Rehabilitation-Innovation/AnkleDynamometer/Hardware/AnkleDynamometer/AnkleDynamometer.kicad_pcb

## KiCad design Hardware/AnkleDynamometer/AnkleDynamometer.kicad_pcb (2026-08-28)

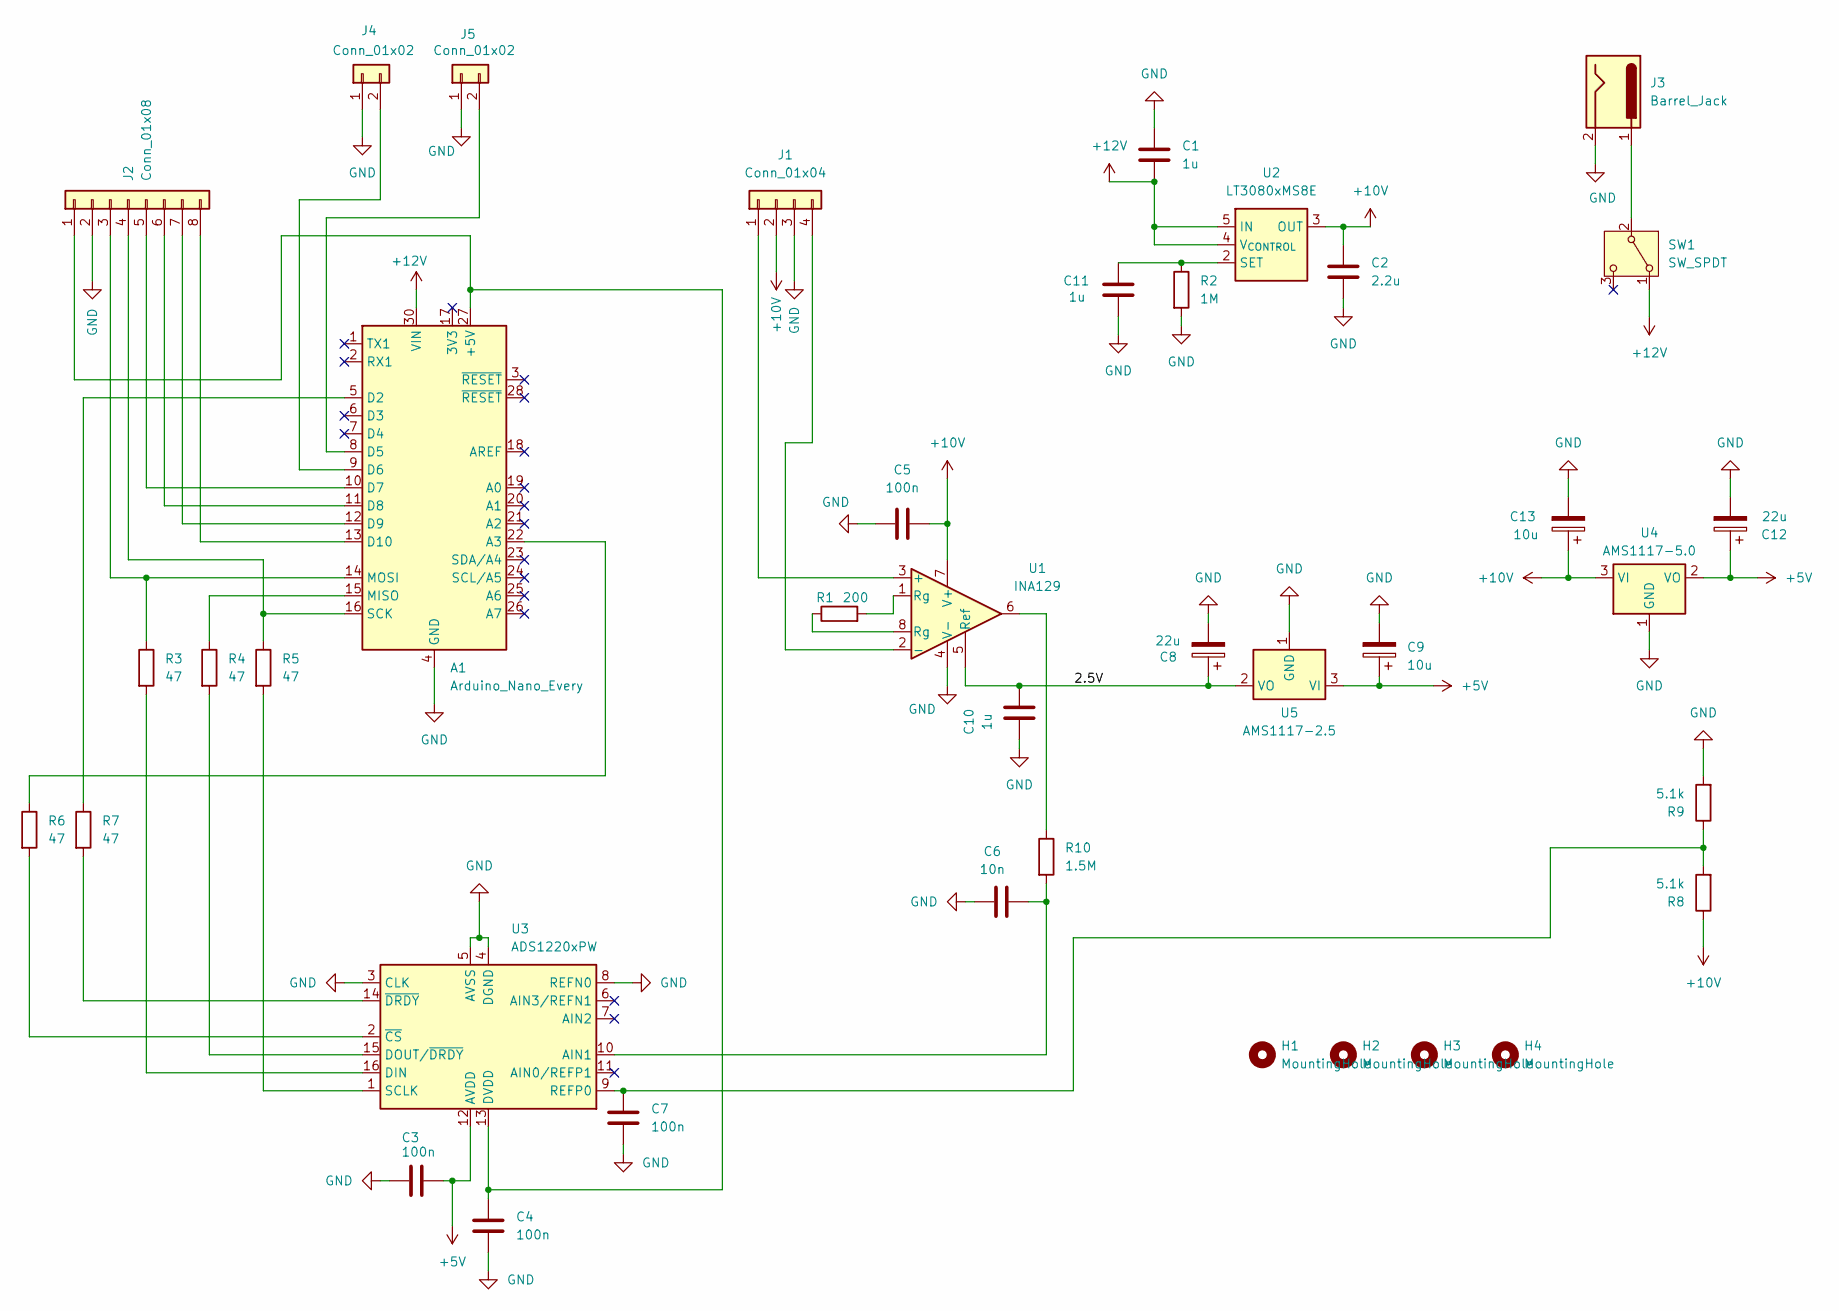
[picture p1: schematic AnkleDynamometer.kicad_sch]

Parts:
A1: Arduino_Nano_Every; Arduino_Nano
C1, C10, C11: 1u; C_0805_2012Metric; LCSC C28323
C2: 2.2u; C_1206_3216Metric; LCSC C50254
C3, C4, C5, C7: 100n; C_0603_1608Metric; LCSC C14663
C6: 10n; C_0603_1608Metric; LCSC C85973
C8, C12: 22u; CP_EIA-3216-18_Kemet-A; LCSC C11366
C9, C13: 10u; CP_EIA-3216-18_Kemet-A; LCSC C7171
H1, H2, H3, H4: MountingHole; MountingHole_2.2mm_M2_Pad_Via
J1: Conn_01x04; JST_EH_B4B-EH-A_1x04_P2.50mm_Vertical
J2: Conn_01x08; JST_EH_B8B-EH-A_1x08_P2.50mm_Vertical
J3: Barrel_Jack; BarrelJack_Horizontal
J4, J5: Conn_01x02; JST_EH_B2B-EH-A_1x02_P2.50mm_Vertical
R1: 200; R_0603_1608Metric_Pad0.98x0.95mm_HandSolder; LCSC C8218
R2: 1M; R_0603_1608Metric_Pad0.98x0.95mm_HandSolder; LCSC C22935
R3, R4, R5, R6, R7: 47; R_0603_1608Metric_Pad0.98x0.95mm_HandSolder; LCSC C23182
R8, R9: 5.1k; R_0603_1608Metric_Pad0.98x0.95mm_HandSolder; LCSC C23186
R10: 1.5M; R_0603_1608Metric_Pad0.98x0.95mm_HandSolder; LCSC C137773
SW1: SW_SPDT; SW_SLW-121586-5A-D
U1: INA129; DIP-8_W7.62mm
U2: LT3080xMS8E; TO-263-5_TabPin3; LCSC C580029
U3: ADS1220xPW; TSSOP-16_4.4x5mm_P0.65mm; LCSC C48263
U4: AMS1117-5.0; SOT-223-3_TabPin2; LCSC C6187
U5: AMS1117-2.5; SOT-223-3_TabPin2; LCSC C12087

Connections:
+5V: C3.1, C9.1, C12.1, U3.12 (AVDD), U4.2 (VO), U5.3 (VI)
+10V: C2.1, C5.2, C13.1, J1.2, R8.1, U1.7 (V+), U2.3 (OUT), U4.3 (VI)
+12V: A1.30 (VIN), C1.2, SW1.1 (A), U2.4 (V_{CONTROL}), U2.5 (IN)
/2.5V: C8.1, C10.2, U1.5 (Ref), U5.2 (VO)
GND: A1.4 (GND), A1.29 (GND), C1.1, C2.2, C3.2, C4.1, C5.1, C6.1, C7.1, C8.2, C9.2, C10.1, C11.2, C12.2, C13.2, J1.3, J2.2, J3.2, J4.1, J5.1, R2.2, R9.2, U1.4 (V-), U3.3 (CLK), U3.4 (DGND), U3.5 (AVSS), U3.8 (REFN0), U4.1 (GND), U5.1 (GND)
unnamed: A1.27 (+5V), C4.2, J2.1, U3.13 (DVDD)
unnamed: A1.22 (A3), R6.1
unnamed: A1.5 (D2), R7.1
unnamed: A1.8 (D5), J5.2
unnamed: A1.9 (D6), J4.2
unnamed: A1.10 (D7), J2.5
unnamed: A1.11 (D8), J2.6
unnamed: A1.12 (D9), J2.7
unnamed: A1.13 (D10), J2.8
unnamed: A1.15 (MISO), R4.1
unnamed: A1.14 (MOSI), J2.3, R3.1
unnamed: A1.16 (SCK), J2.4, R5.1
unnamed: J1.1, U1.3 (+)
unnamed: J1.4, U1.2 (-)
unnamed: R1.1, U1.8 (Rg)
unnamed: R1.2, U1.1 (Rg)
unnamed: R10.1, U1.6
unnamed: J3.1, SW1.2 (B)
unnamed: C11.1, R2.1, U2.2 (SET)
unnamed: C6.2, R10.2, U3.10 (AIN1)
unnamed: R3.2, U3.16 (DIN)
unnamed: R4.2, U3.15 (DOUT/~DRDY)
unnamed: C7.2, R8.2, R9.1, U3.9 (REFP0)
unnamed: R5.2, U3.1 (SCLK)
unnamed: R6.2, U3.2 (~CS)
unnamed: R7.2, U3.14 (~DRDY)

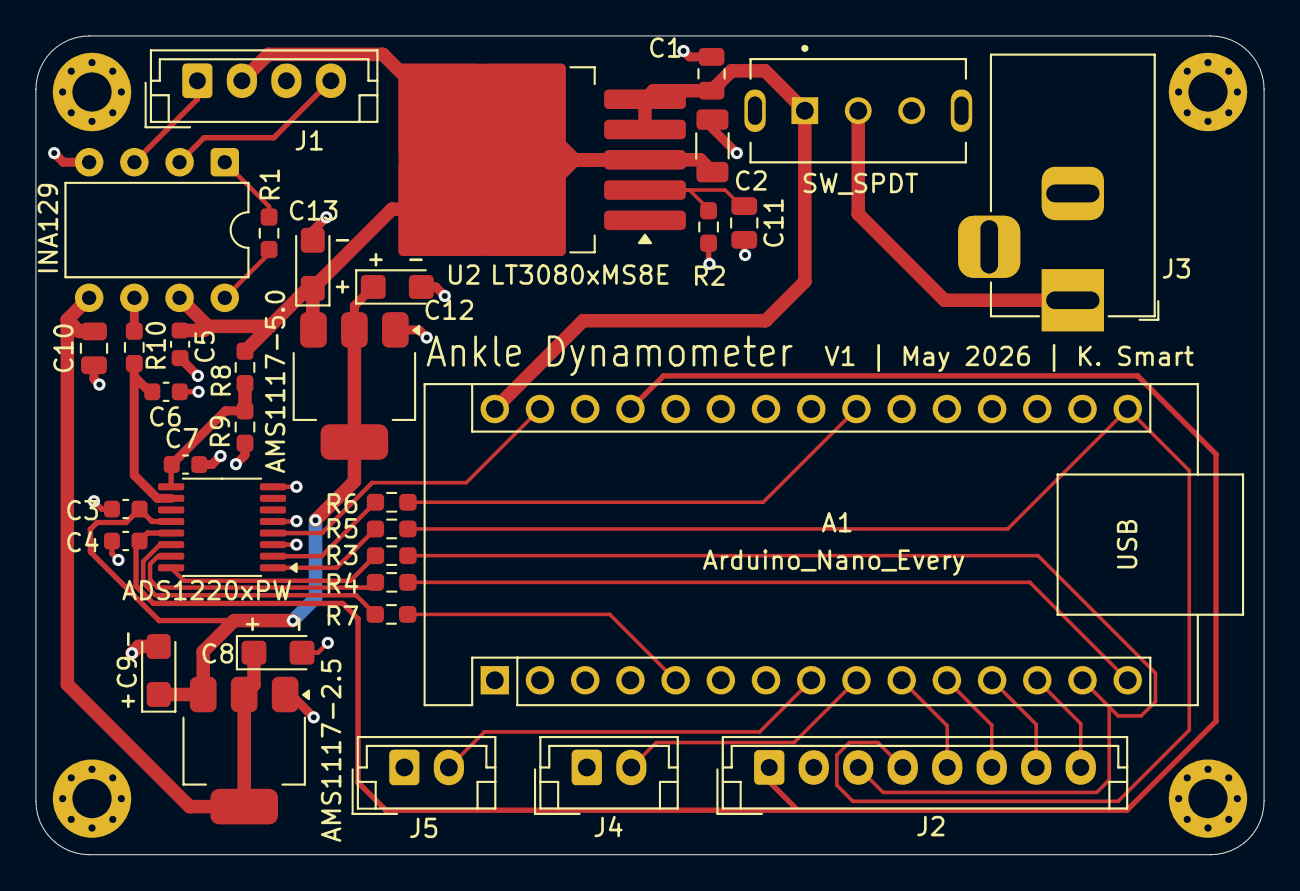
[picture p2: board AnkleDynamometer.kicad_pcb from above]

Board: 2 copper layers, 69.0 x 46.0 mm, 39 parts (0 on the bottom side), 31 nets.
