Rehabilitation-Innovation/AnkleDynamometer/txt_Calibration/RepeatabilityTest_27kg.txt

Config_Reg : 
1
4
50
0
 
4133721 8261748 12389632 16517263 20645080 24772977 28900767 33028641 37156283 41284112 45411801 49539408 53667024 57794662 61922440 66050385 70178090 74305637 78433180 82560916 Average: 4128045
0 -0.01 4127629
1 -0.01 4127751
2 -0.01 4127788
3 -0.00 4127847
4 -0.00 4127842
5 -0.01 4127814
6 -0.01 4127812
7 -0.01 4127808
8 -0.01 4127809
9 -0.01 4127797
10 -0.01 4127797
11 -0.01 4127776
12 -0.01 4127792
13 -0.01 4127777
14 -0.01 4127796
15 -0.01 4127834
16 -0.01 4127809
17 -0.01 4127819
18 -0.01 4127792
19 -0.01 4127800
20 -0.01 4127801
21 -0.01 4127770
22 -0.01 4127740
23 -0.01 4127740
24 -0.01 4127716
25 -0.01 4127701
26 -0.01 4127704
27 -0.01 4127685
28 -0.01 4127706
29 -0.01 4127672
30 -0.01 4127704
31 -0.01 4127735
32 -0.01 4127708
33 -0.01 4127743
34 -0.01 4127808
35 -0.00 4127901
36 -0.00 4127904
37 -0.00 4127953
38 -0.00 4127977
39 -0.00 4127979
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
