Rehabilitation-Innovation/AnkleDynamometer/LoadCellValidation.xlsx

Sheet: Calibration
0 | 4125106 | 0 | 4123962 | 0 | 4125617 | 0 | 4094992 |  |  | ADC Value
1 | 4125083 | 1 | 4123962 | 1 | 4125547 | 1 | 4095093 |  | Known masses | Increasing | Decreasing
2 | 4125034 | 2 | 4123964 | 2 | 4125484 | 2 | 4095054 |  | -18.3 | 3335661.19
3 | 4125053 | 3 | 4124032 | 3 | 4125568 | 3 | 4094994 |  | -9.2 | 3715514.19
4 | 4124961 | 4 | 4123943 | 4 | 4125394 | 4 | 4095040 |  | 0 | 4125184.048
5 | 4125116 | 5 | 4123946 | 5 | 4125419 | 5 | 4095012 |  | 9.0 | 4496124.3 | 4490965.714
6 | 4125079 | 6 | 4124057 | 6 | 4125525 | 6 | 4095035 |  | 18.1 | 4872486.762 | 4864073.095
7 | 4125149 | 7 | 4123990 | 7 | 4125475 | 7 | 4095351 |  | 27.3 | 5245785.143 | 5238596
8 | 4124993 | 8 | 4123951 | 8 | 4125473 | 8 | 4095022 |  | 34.9 | 5555335.952 | 5557937.571
9 | 4125070 | 9 | 4123972 | 9 | 4125502 | 9 | 4095149 |  | 44.3 | 5935980.095 | 5942394.286
10 | 4125058 | 10 | 4123923 | 10 | 4125647 | 10 | 4094994 |  | 55.1 | 6411038.333 | 6411038.333
11 | 4125046 | 11 | 4123949 | 11 | 4125472 | 11 | 4095105 |  | 62.8 | 6616478.429 | 6590787.238
12 | 4125028 | 12 | 4123956 | 12 | 4125496 | 12 | 4094978 |  | 70.4 | 6920726
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
