Rehabilitation-Innovation/AnkleDynamometer/AnklePositionValidation.xlsx

Sheet: Sheet1
95% range | plot distance | Max plantar | Max dorsi | Block [in] | Block [mm] |  |  | 0.375
1.5 | 10 | 30 | -10 | 0.5 | 12.7
L1 | h | L2 | L3 | BC | beta [rad] | beta [deg]
28 | 4.5 | 4 | 5 | 28.44292531 | 0.1767088561 | 10.12467166
Foot size data
 |  | Maeolus Anterior/Posterior Location |  |  | Maeolus Distal/Proximal Location
Age | Foot position | Lateral | Medial | Average | Lateral | Medial | Average
Adult | 0 | 4.5 | 6 | 5.25 | 9 | 10 | 9.5
 | 30 | 6 | 7 | 6.5 | 9 | 9 | 9
 | -10 | 5 | 2.5 | 3.75 | 9.5 | 9.5 | 9.5
4 yrs | 0 | 2 | 3 | 2.5 | 5.5 | 6 | 5.75
 | 30 | 2.5 | 3.5 | 3 | 5.5 | 6 | 5.75
 | -10 | 2.5 | 3 | 2.75 | 5 | 5.5 | 5.25
Plotting ankle position
 | 0 |  | 30 |  | -10
 | x | y | x | y | x | y
Adult | 9.5 | 5.25 | 21.79422863 | 6.5 | 4.499064308 | 3.75
4 yrs | 5.75 | 3.77 | 19.32894298 | 4.27 | 0.2311094926 | 4.02
Axis of Rotation
 |  | Position
 |  | x | y
0 | Upper bound | 5 | 6
 | Axis of rotation | 5 | 4.5
 | Lower bound | 5 | 3 |  |  |  | -1.52
30 | Upper bound | 17.58012702 | 5.799038106
 | Axis of rotation | 18.33012702 | 4.5
 | Lower bound | 19.08012702 | 3.200961894
-10 | Upper bound | 0.3223620569 | 5.97721163
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
