Rehabilitation-Innovation/AnkleDynamometer/txt_NoiseTesting/FilteringData.xlsx

Sheet: PCB Noise
 |  | PCB_ADS1220ExtRef_INA129_LP_LoadCell_none |  |  |  |  | PCB_ADS1220ExtRef_INA129_LP_LoadCell_AvgFilter |  |  |  |  | 12mins_PCB_ADS1220ExtRef_INA129_LP_LoadCell_AvgFilter |  |  |  |  | 6mins_PCB_ADS1220ExtRef_INA129_LP_LoadCell_AvgFilter |  |  |  |  | 6mins_PCB_ADS1220ExtRef_INA129_LP_LoadCell_AvgFilter |  |  |  |  | 6mins_PCB_ADS1220ExtRef_INA129_LP_LoadCell_AvgFilter
FSR [bits] | 23 | data pt | code |  | [codes] | [V] | data pt | code |  | [codes] | [V] | data pt | code |  | [codes] | [V] | data pt | code |  | [codes] | [V] | data pt | code |  | [codes] | [V] | data pt | code |  | [codes] | [V]
FSR [counts] | 8388608 | 0 |  | ADC bits | 23 |  | 0 |  | ADC bits | 23 |  | 0 |  | ADC bits | 23 |  | 0 | 4093617 | ADC bits | 23 |  | 0 |  | ADC bits | 23 |  | 0 |  | ADC bits | 23
FSR [V] |  | 1 |  | Avg | 4097692.492 |  | 1 |  | Avg | 4098063.199 |  | 1 |  | Avg | 4092293.357 |  | 1 | 4093037 | Avg | 4092669.151 |  | 1 |  | Avg | 4093467.124 |  | 1 |  | Avg | 4191390.513
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
