Rehabilitation-Innovation/AnkleDynamometer/AnkleDyn_Firmware/LCD_2inch/LCD_2inch.ino

#include <SPI.h>
#include "LCD_Driver.h"
#include "GUI_Paint.h"
#include "image.h"

int count = 0; 
char myChar[10];

void setup()
{
  Config_Init();
  LCD_Init();
  LCD_Clear(0xffff);
  Paint_NewImage(LCD_HEIGHT, LCD_WIDTH, 0, WHITE);
  Paint_Clear(WHITE);
  Paint_DrawString_EN(10, 10, "Ankle", &Font24, WHITE, BLACK);
  Paint_DrawString_EN(10, 30, "Dynamometer", &Font24, WHITE, BLACK);
  Paint_DrawString_EN(10, 70, "Count:", &Font24, WHITE, BLACK);
  Paint_DrawString_EN(130, 70, "    ", &Font24, YELLOW, BLACK);

  //Paint_DrawString_EN(30, 34, "ABC", &Font24, BLUE, CYAN);
  
  // Paint_DrawString_CN(50,180, "微雪电子",  &Font24CN, WHITE, RED);
  
  // Paint_DrawRectangle(125, 10, 225, 58, RED,  DOT_PIXEL_2X2,DRAW_FILL_EMPTY);
  // Paint_DrawLine(125, 10, 225, 58, MAGENTA,   DOT_PIXEL_2X2,LINE_STYLE_SOLID);
  // Paint_DrawLine(225, 10, 125, 58, MAGENTA,   DOT_PIXEL_2X2,LINE_STYLE_SOLID);
  
  // Paint_DrawCircle(150,100, 25, BLUE,   DOT_PIXEL_2X2,   DRAW_FILL_EMPTY);
  // Paint_DrawCircle(180,100, 25, BLACK,  DOT_PIXEL_2X2,   DRAW_FILL_EMPTY);
  // Paint_DrawCircle(210,100, 25, RED,    DOT_PIXEL_2X2,   DRAW_FILL_EMPTY);
  // Paint_DrawCircle(165,125, 25, YELLOW, DOT_PIXEL_2X2,   DRAW_FILL_EMPTY);
  // Paint_DrawCircle(195,125, 25, GREEN,  DOT_PIXEL_2X2,   DRAW_FILL_EMPTY);
  
  

  // Paint_DrawImage(gImage_70X70, 20, 80, 70, 70); 
  // //Paint_DrawFloatNum (5, 150 ,987.654321,4,  &Font20,    WHITE,   LIGHTGREEN);

}
void loop()
{
  count += 1;
  sprintf(myChar, " %d ", count);
  Paint_DrawString_EN(130, 70, myChar, &Font24, YELLOW, BLACK);
  delay(1000);
}



/*********************************************************************************************************
  END FILE
*********************************************************************************************************/
