Rehabilitation-Innovation/AnkleDynamometer/AnkleDyn_Firmware/MovingAverageFilter.h

#ifndef MOVINGAVERAGEFILTER_H
#define MOVINGAVERAGEFILTER_H

#include <Arduino.h>

class MovingAverageFilter {
    private:
        static const int WINDOW_SIZE = 10;
        uint32_t window[WINDOW_SIZE];
        uint32_t sortedWindow[WINDOW_SIZE];
        int index;
        bool bufferFilled;

    public:
        MovingAverageFilter();
        void addValue(uint32_t value);
        float calculateFilteredValue();
        void clear();
}; 

#endif
