Rehabilitation-Innovation/AnkleDynamometer/(commit log)

2026-01-30 I2C and filtering
2026-04-20 Reorganizing
    Reorganizing files
    [AnklePositionValidation.xlsx]
2026-04-20 Noise testing
    Uploading noise testing files
    [FilteringData.xlsx]
2026-04-22 LCD
    Added the LCD display code included with the display (https://www.waveshare.com/wiki/2inch_LCD_Module?amazon#Arduino_Software_Description) to the setup to test printing out values. Updating the screen is super slow though, should try another library
    [AnkleDynamometer.kicad_pcb, AnkleDynamometer.kicad_sch]
2026-04-22 PCB
    Created and edited kiCAD project for hardware design
    [AnkleDynamometer.kicad_pcb, AnkleDynamometer.kicad_sch]
2026-04-23 PCB Schematic
    Put together the KiCAD schematic
    [AnkleDynamometer.kicad_sch, FilteringData.xlsx]
2026-04-27 PCB
    Updating schematic
    [AnkleDynamometer.kicad_sch, AnklePositionValidation.xlsx]
2026-05-04 PCB layout
    [AnkleDynamometer.kicad_pcb, AnkleDynamometer.kicad_sch]
2026-05-07 PCB layout 2
    [AnkleDynamometer.kicad_pcb, AnkleDynamometer.kicad_sch, bom.csv, designators.csv, positions.csv]
2026-06-29 Firmware updates
    - include zero and max reset buttons
    - calculating torque and rounding to the appropriate resolution
    - Updating display visuals
2026-06-29 PCB Noise Measurements
    Measuring and calculating the noise-free resolution with the PCB
    [FilteringData.xlsx]
2026-06-29 Load cell validation
    Calibrating load cell and checking repeatability and drift
    [AnklePositionValidation.xlsx, LoadCellValidation.xlsx]
2026-08-18 KiCAD file updates
2026-08-24 Recalibrating load cell
    [LoadCellValidation.xlsx]
2026-08-28 PCB Updates
    Updating the PCB design based on testing of the previous design. Also re-exported and tested the production files so it is ready to upload to JLCPCB
    [AnkleDynamometer.kicad_pcb, bom.csv, designators.csv, positions.csv]
